DishanDey04/Quadruped_Spider_Bot_12_DOF_V.6.0/Diagrams/Coordinate frames of the robot.png

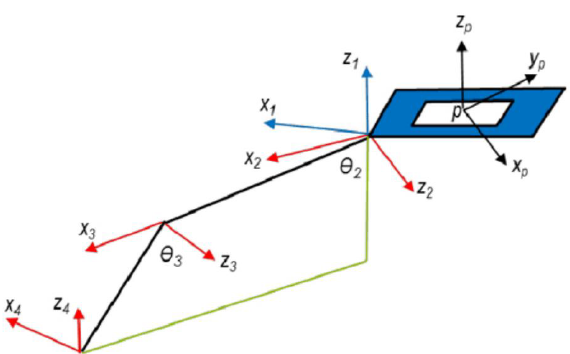
Diagrams/Coordinate frames of the robot.png
