DishanDey04/Quadruped_Spider_Bot_12_DOF_V.6.0/Diagrams/IK1.png

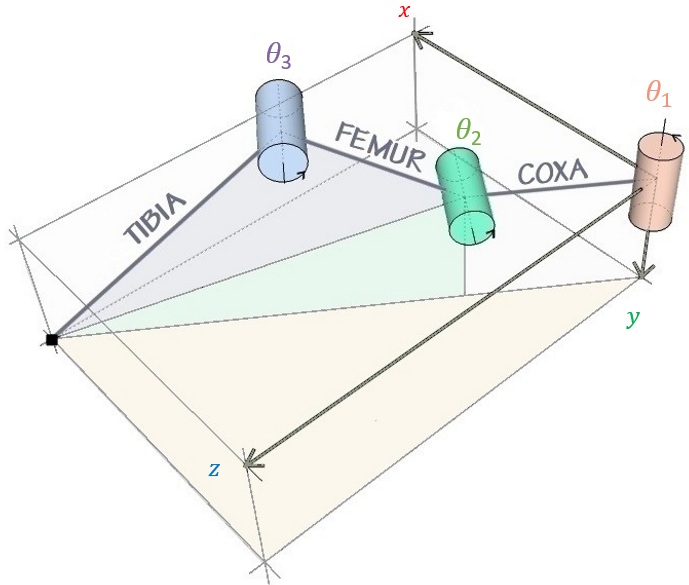
Diagrams/IK1.png
