DishanDey04/Quadruped_Spider_Bot_12_DOF_V.6.0/Diagrams/IK2.png

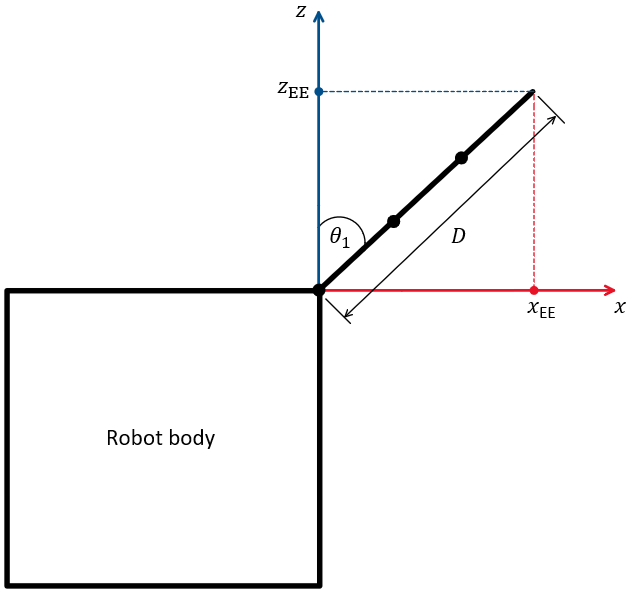
Diagrams/IK2.png
