DishanDey04/Quadruped_Spider_Bot_12_DOF_V.6.0/3D Parts/hinge.stl

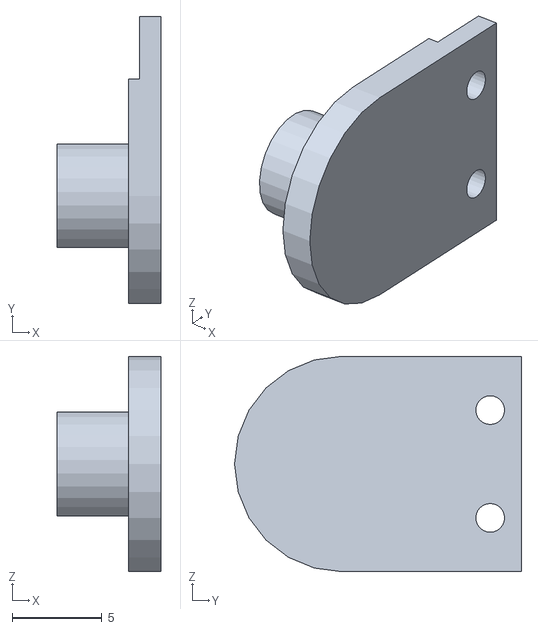
[picture p13: CAD file, 2026-02-26]
3D Parts/hinge.stl
5.79 x 16.0 x 12.0
