DishanDey04/Quadruped_Spider_Bot_12_DOF_V.6.0/3D Parts/body-d.stl

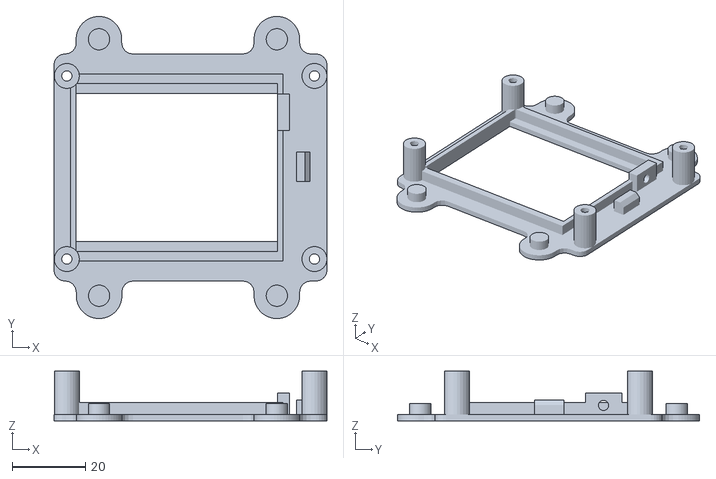
[picture p14: CAD file, 2026-02-26]
3D Parts/body-d.stl
74.4 x 82.4 x 13.5
