DishanDey04/Quadruped_Spider_Bot_12_DOF_V.6.0/3D Parts/tibia-f.stl

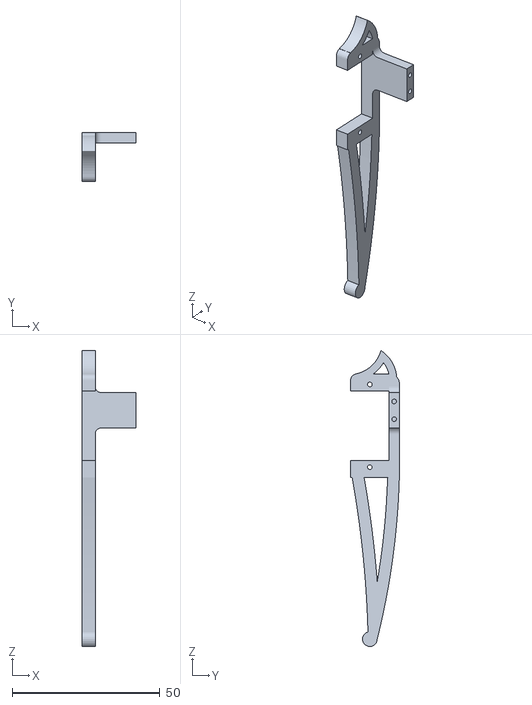
[picture p15: CAD file, 2026-02-26]
3D Parts/tibia-f.stl
18.3 x 16.5 x 100.2
