DishanDey04/Quadruped_Spider_Bot_12_DOF_V.6.0/3D Parts/coxa-f.stl

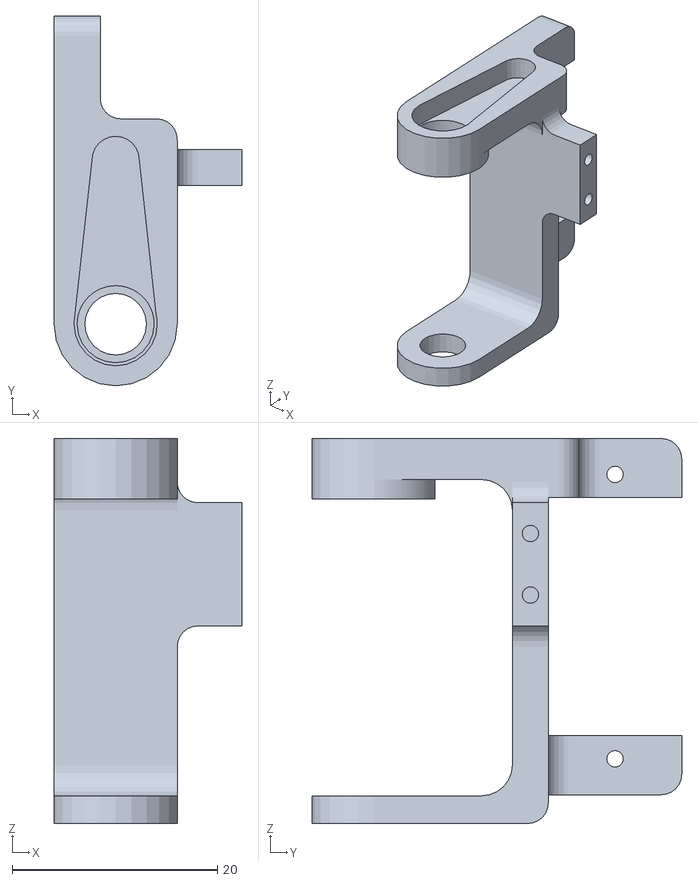
[picture p16: CAD file, 2026-02-26]
3D Parts/coxa-f.stl
18.3 x 36.0 x 37.5
