DishanDey04/Quadruped_Spider_Bot_12_DOF_V.6.0/3D Parts/body-m.stl

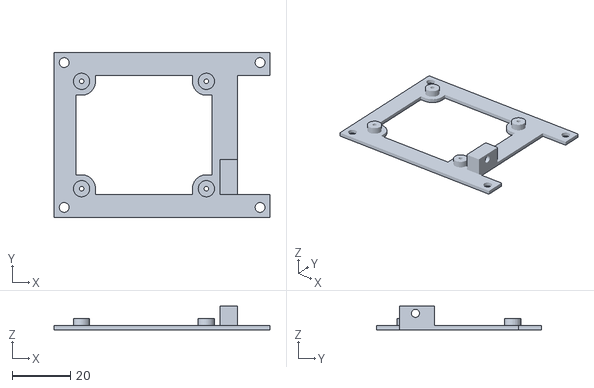
[picture p17: CAD file, 2026-02-26]
3D Parts/body-m.stl
74.4 x 56.9 x 8.20
