DishanDey04/Quadruped_Spider_Bot_12_DOF_V.6.0/3D Parts/femur.stl

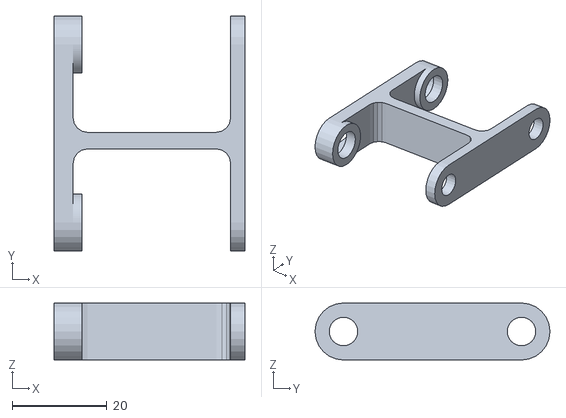
[picture p18: CAD file, 2026-02-26]
3D Parts/femur.stl
40.2 x 49.5 x 12.0
