DishanDey04/Quadruped_Spider_Bot_12_DOF_V.6.0/3D Parts/body-u.stl

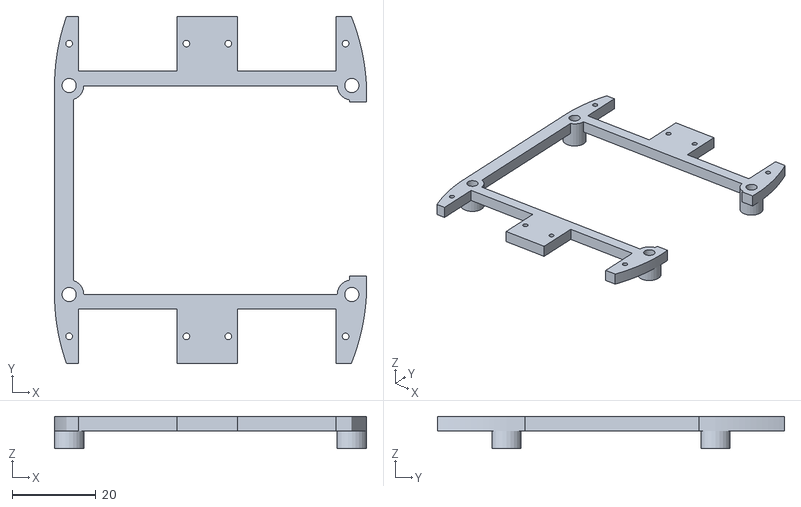
[picture p19: CAD file, 2026-02-26]
3D Parts/body-u.stl
74.5 x 82.9 x 7.70
