DishanDey04/Quadruped_Spider_Bot_12_DOF_V.6.0/(list of files, cad)

Other CAD files:
3D Parts/tibia-b.stl
3D Parts/coxa-b.stl
