DishanDey04/Quadruped_Spider_Bot_12_DOF_V.6.0/Q_BEE_V6_motion.h

// ...existing code...
#ifndef Q_BEE_V6_MOTION_H
#define Q_BEE_V6_MOTION_H

#include "Q_BEE_V6_state.h"

void set_site(int leg, float x, float y, float z);
void wait_reach(int leg);
void wait_all_reach(void);

#endif // Q_BEE_V6_MOTION_H
