DishanDey04/Quadruped_Spider_Bot_12_DOF_V.6.0/(commit log)

2026-02-26 Added readme file and 3d models
    [body-d.stl, body-m.stl, body-u.stl, coxa-b.stl, coxa-f.stl, femur.stl, hinge.stl, tibia-b.stl]
2026-02-27 Circuit diagram added final 3D model
